JUST-CSE-15-IoT-Group-2/smart-fish-pond-management-system/(commit log)

2026-06-15 add currently developed portion
2026-06-22 add motor features and sensor reading features
2026-06-29 fix landing page
